aelevine99/ME691_Windshield-Heater/Photos/PXL_20240503_170951732.jpg

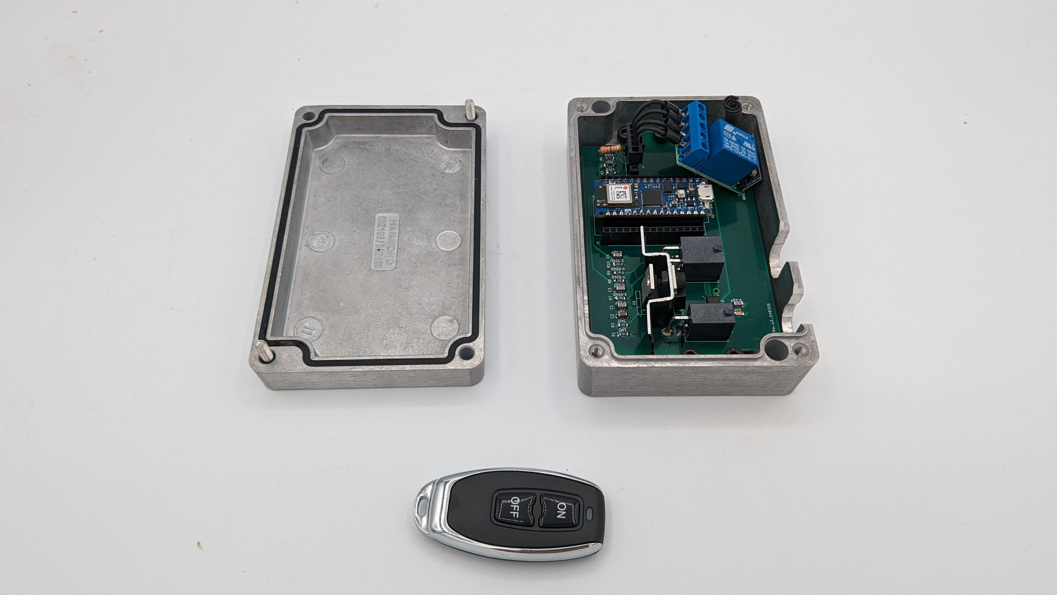
Photos/PXL_20240503_170951732.jpg
