aelevine99/ME691_Windshield-Heater/CAD/Drawing Die-Cut.pdf

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

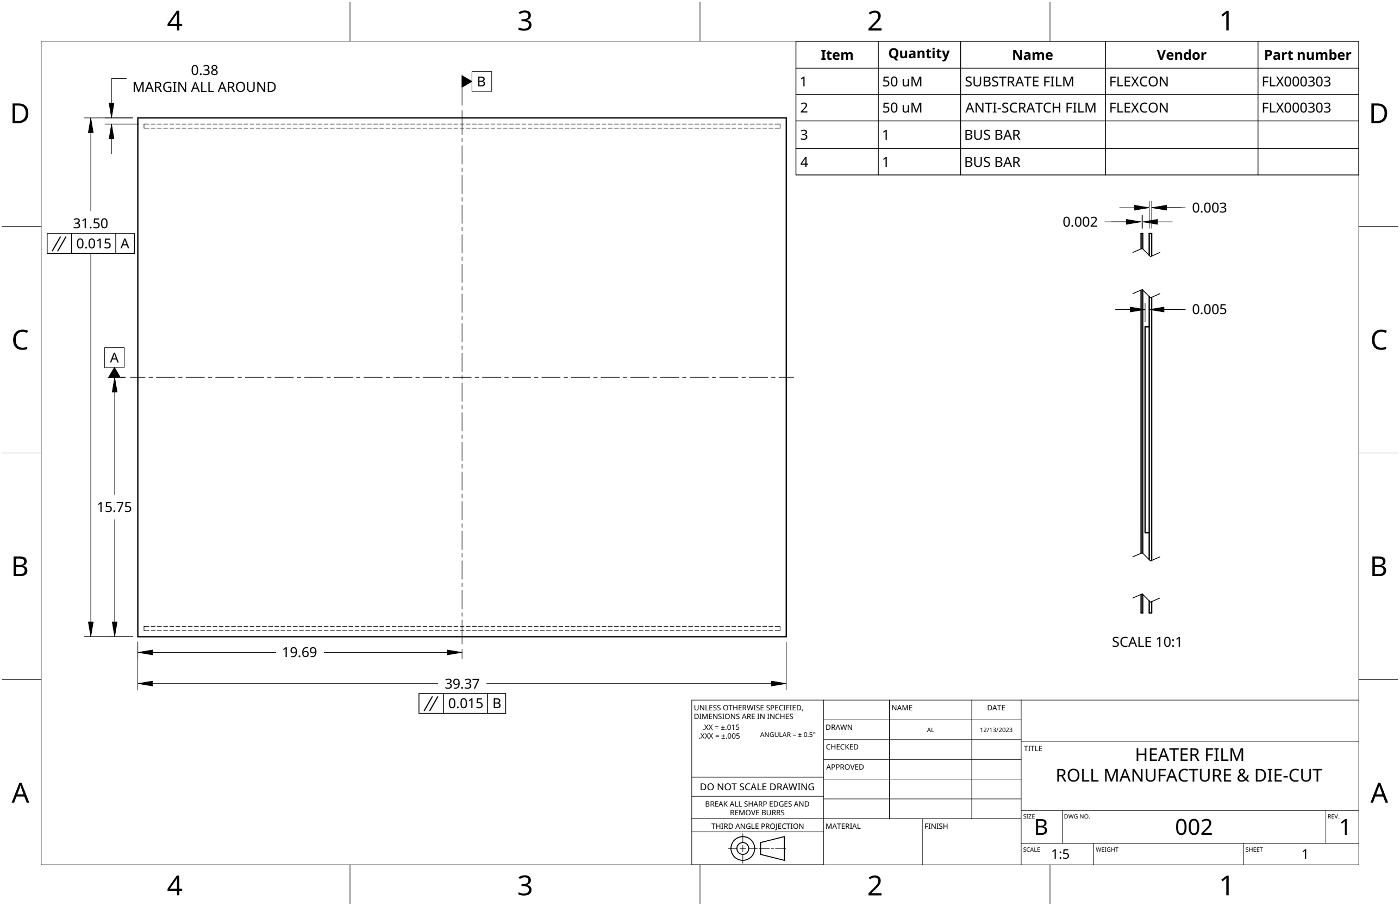
[picture p3: figure]
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
