aelevine99/ME691_Windshield-Heater/kicad/V3/render_iso.png

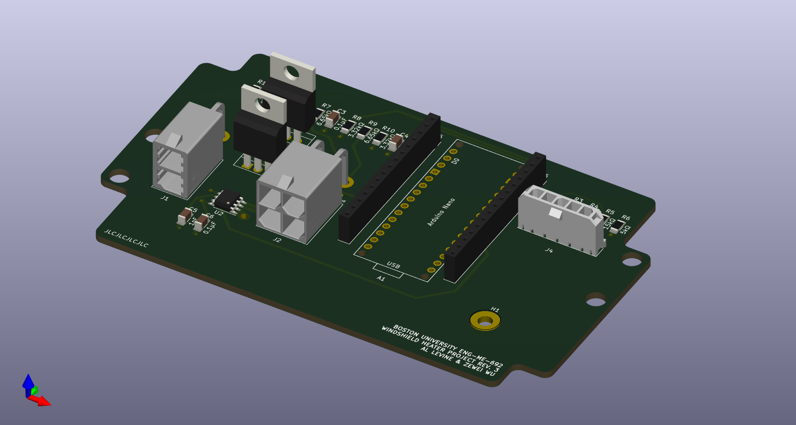
kicad/V3/render_iso.png
