aelevine99/ME691_Windshield-Heater/Photos/PXL_20240503_170716707.jpg

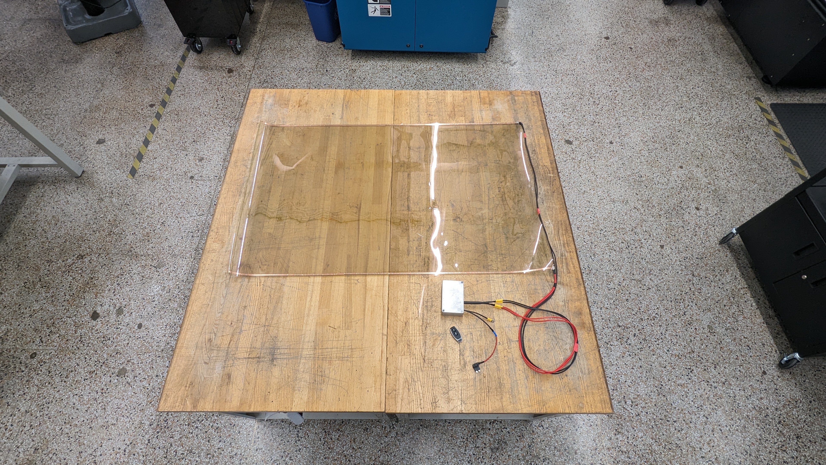
Photos/PXL_20240503_170716707.jpg
