aelevine99/ME691_Windshield-Heater/Photos/PXL_20240503_171204627.jpg

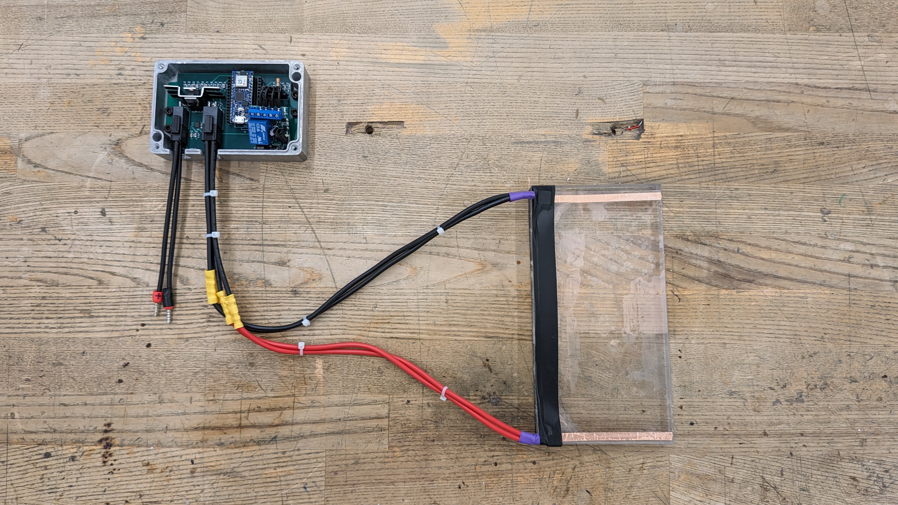
Photos/PXL_20240503_171204627.jpg
