aelevine99/ME691_Windshield-Heater/enclosure/Part Studio 1 - PCB.dxf

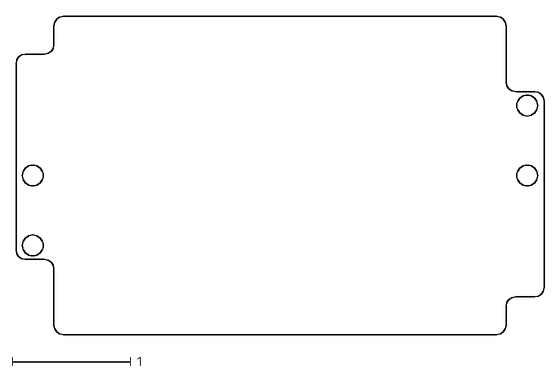
[picture p10: CAD file, 2024-02-08]
enclosure/Part Studio 1 - PCB.dxf
4.46 x 2.69
