aelevine99/ME691_Windshield-Heater/enclosure/1550Z107 asm v1 090904.stp

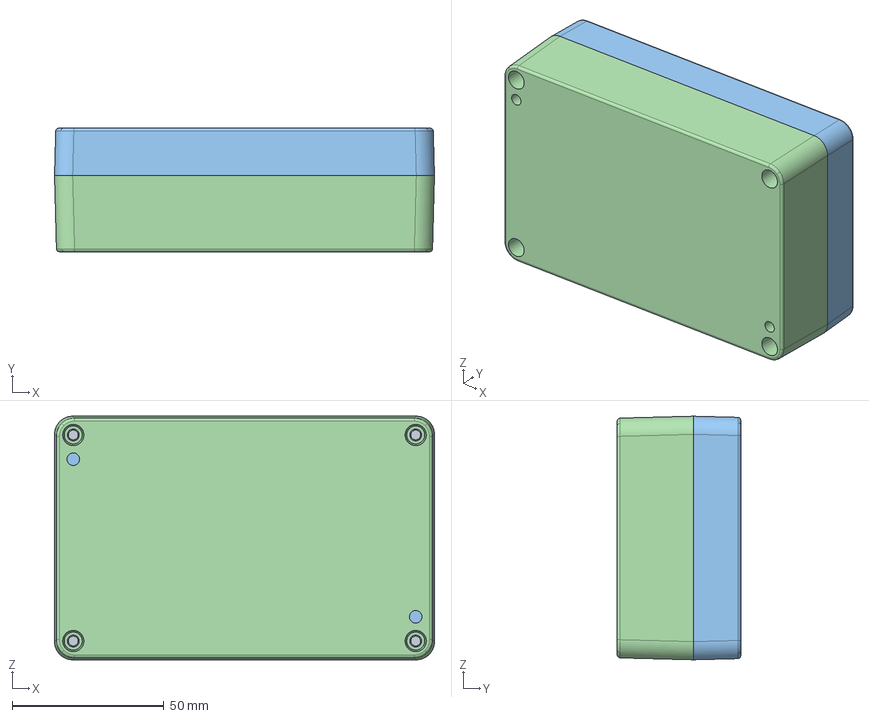
[picture p11: CAD file, 2024-02-06]
enclosure/1550Z107 asm v1 090904.stp
125.4 x 40.8 x 80.4 mm
M4x0.7x30 Flat Cross_B18.6.7M - M4 x 0.7 x 40 Type I Cross Recessed FHMS --40N x 4
1550Z107 gasket v1 091103_w]
1550Z108 LID v1 090904_w]
1550Z107 BOX v1 090904_w]
