aelevine99/ME691_Windshield-Heater/kicad/symbols/0768250004.STEP

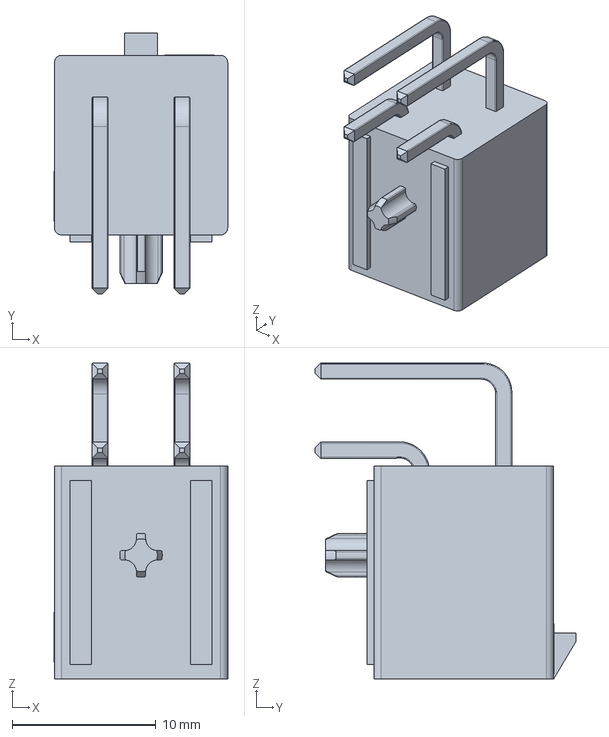
[picture p12: CAD file, 2024-03-22]
kicad/symbols/0768250004.STEP
12.1 x 18.1 x 22.0 mm
