aelevine99/ME691_Windshield-Heater/kicad/symbols/0436500400.step

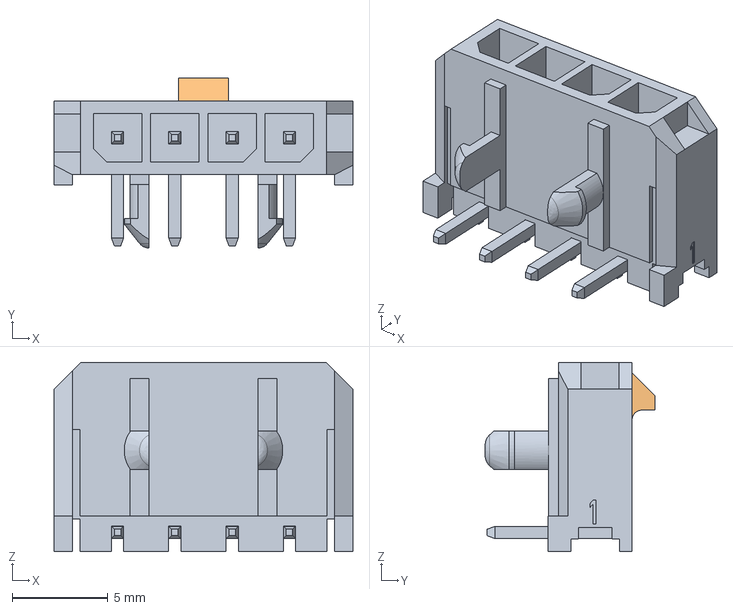
[picture p13: CAD file, 2024-02-15]
kicad/symbols/0436500400.step
15.7 x 8.91 x 9.90 mm
