aelevine99/ME691_Windshield-Heater/kicad/symbols/0768250002.step

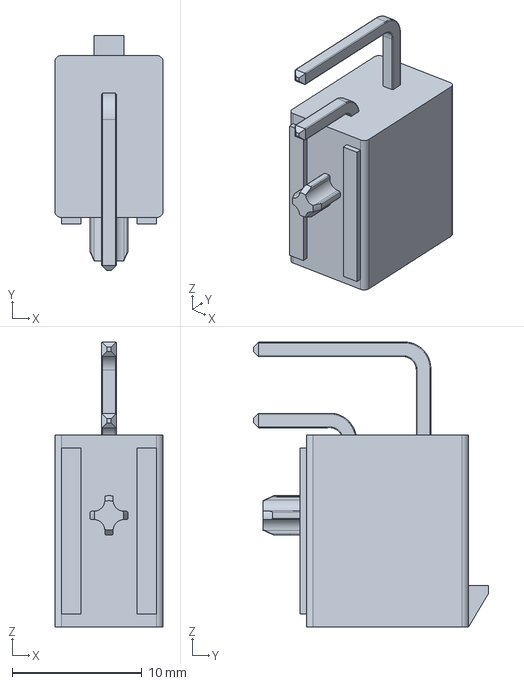
[picture p14: CAD file, 2024-02-15]
kicad/symbols/0768250002.step
8.35 x 18.1 x 22.0 mm
