aelevine99/ME691_Windshield-Heater/kicad/symbols/436500515.step

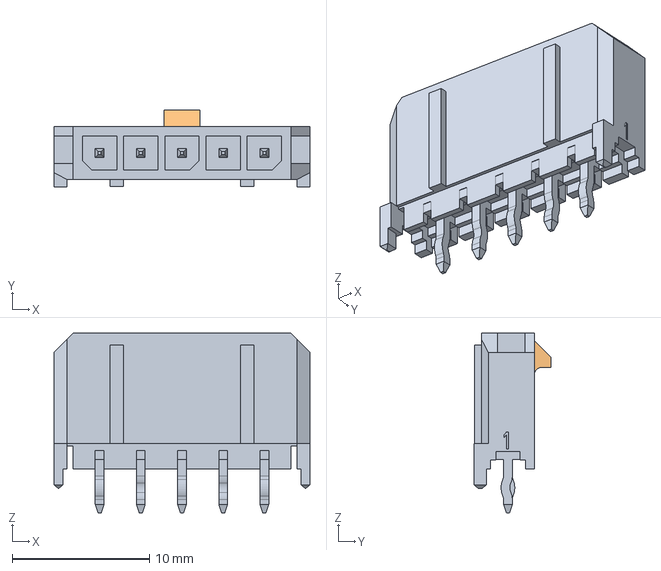
[picture p15: CAD file, 2024-02-15]
kicad/symbols/436500515.step
18.6 x 5.61 x 13.1 mm
