aelevine99/ME691_Windshield-Heater/(list of files, cad)

Other CAD files:
enclosure/1550Z107.dwg
