aelevine99/ME691_Windshield-Heater/CAD/Foil Connector.pdf

4

3

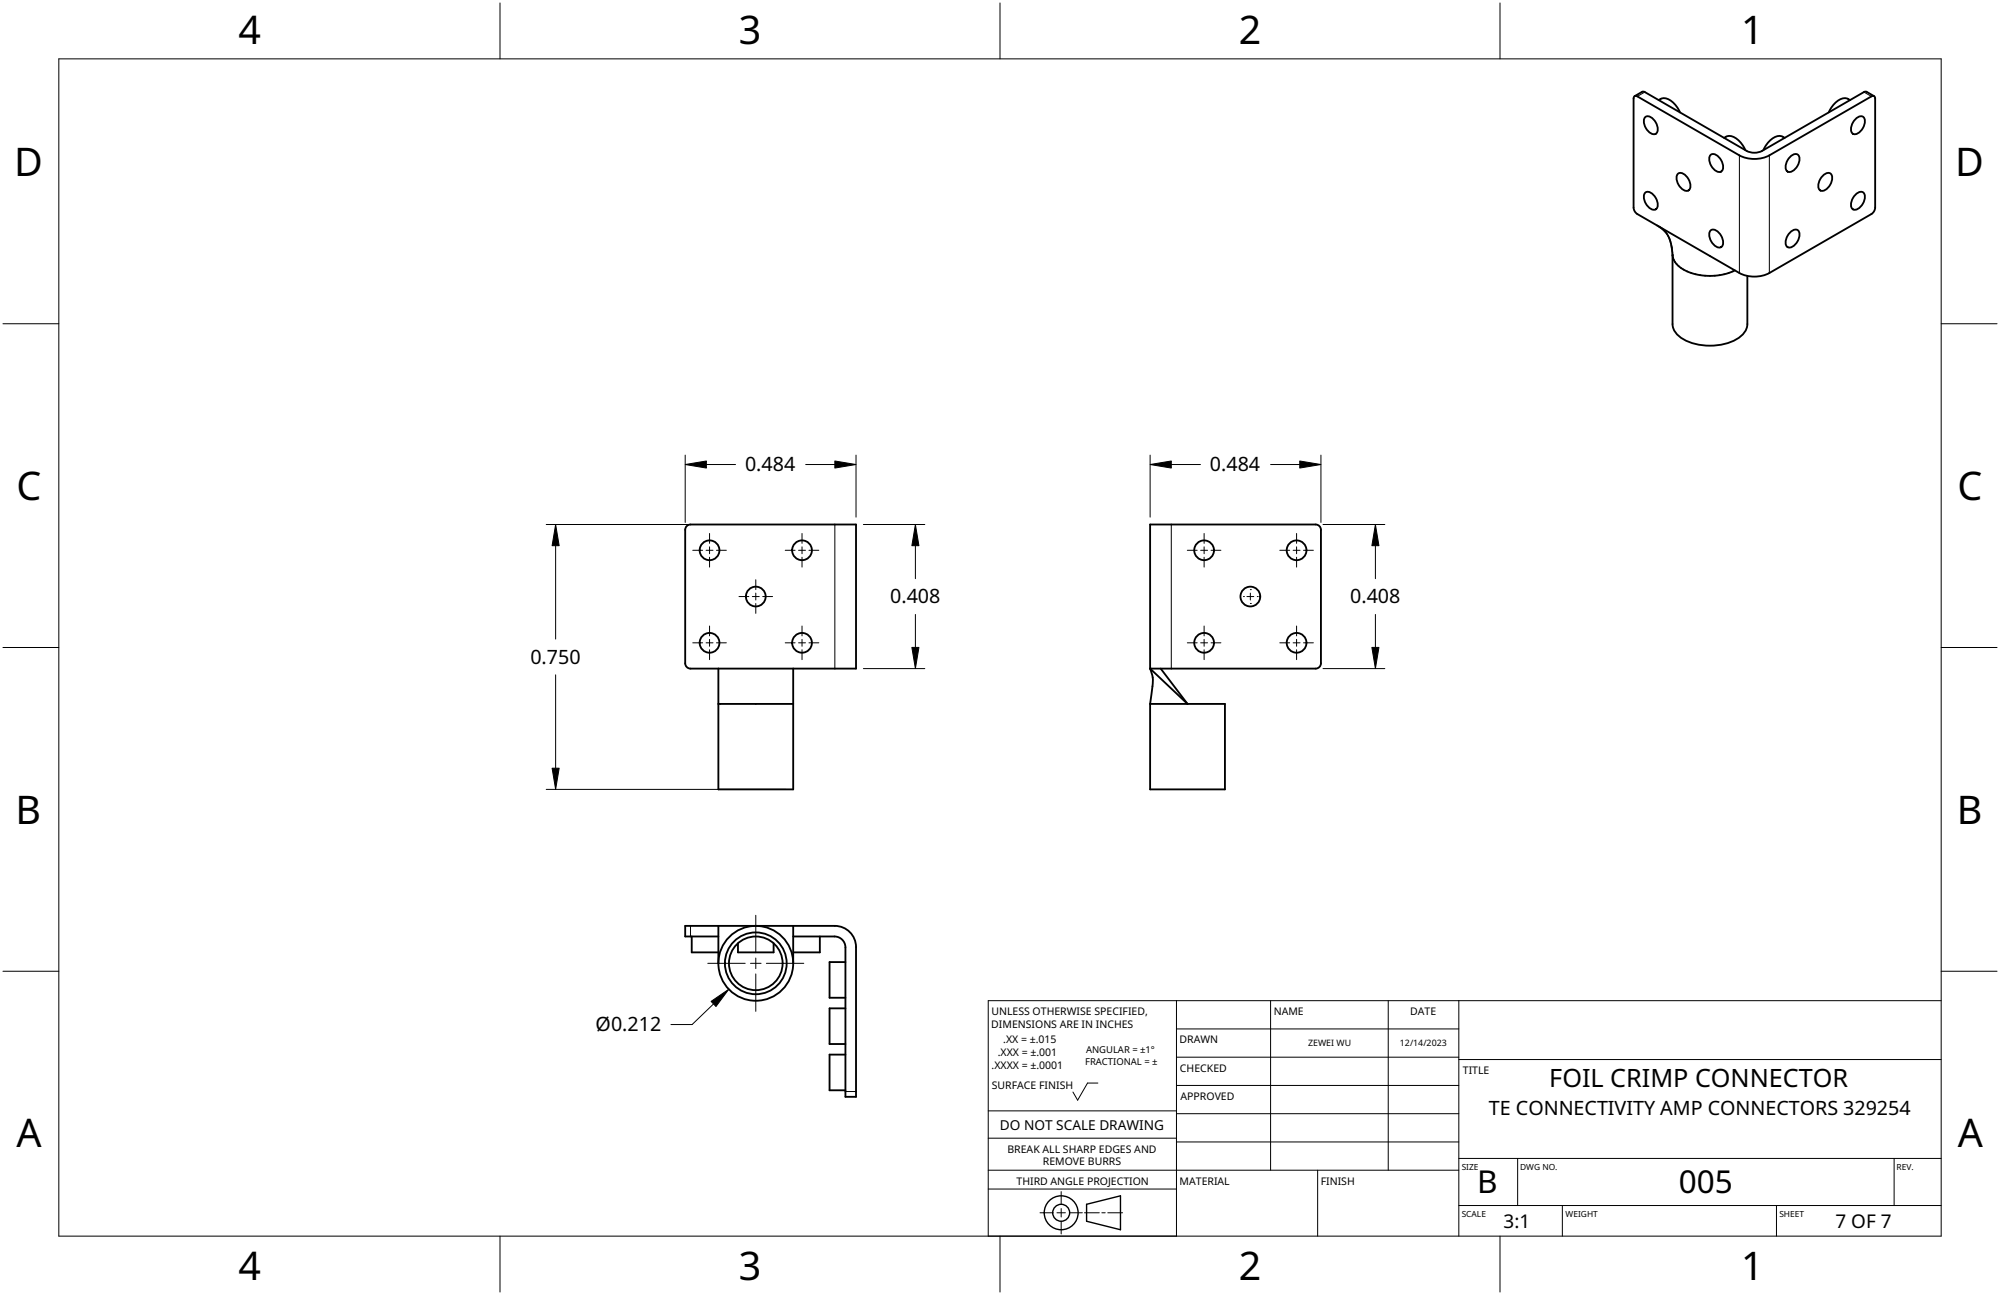
[picture p16: page 1]
MATERIAL; FINISH

UNLESS OTHERWISE SPECIFIED, DIMENSIONS ARE IN INCHES .XX = ±.015 ANGULAR = ±1° .XXX = ±.001 .XXXX = ±.0001 FRACTIONAL = ± SURFACE FINISH | | NAME | DATE

DRAWN | ZEWEI WU | 12/14/2023

CHECKED | | | TITLE FOIL CRIMP CONNECTOR TE CONNECTIVITY AMP CONNECTORS 329254

APPROVED

DO NOT SCALE DRAWING

BREAK ALL SHARP EDGES AND

REMOVE BURRS
THIRD ANGLE PROJECTION

SIZE B | DWG NO. 005 | REV.

SCALE 3:1 | WEIGHT | SHEET
