aelevine99/ME691_Windshield-Heater/CAD/moniOTO Drawing.pdf

4

3

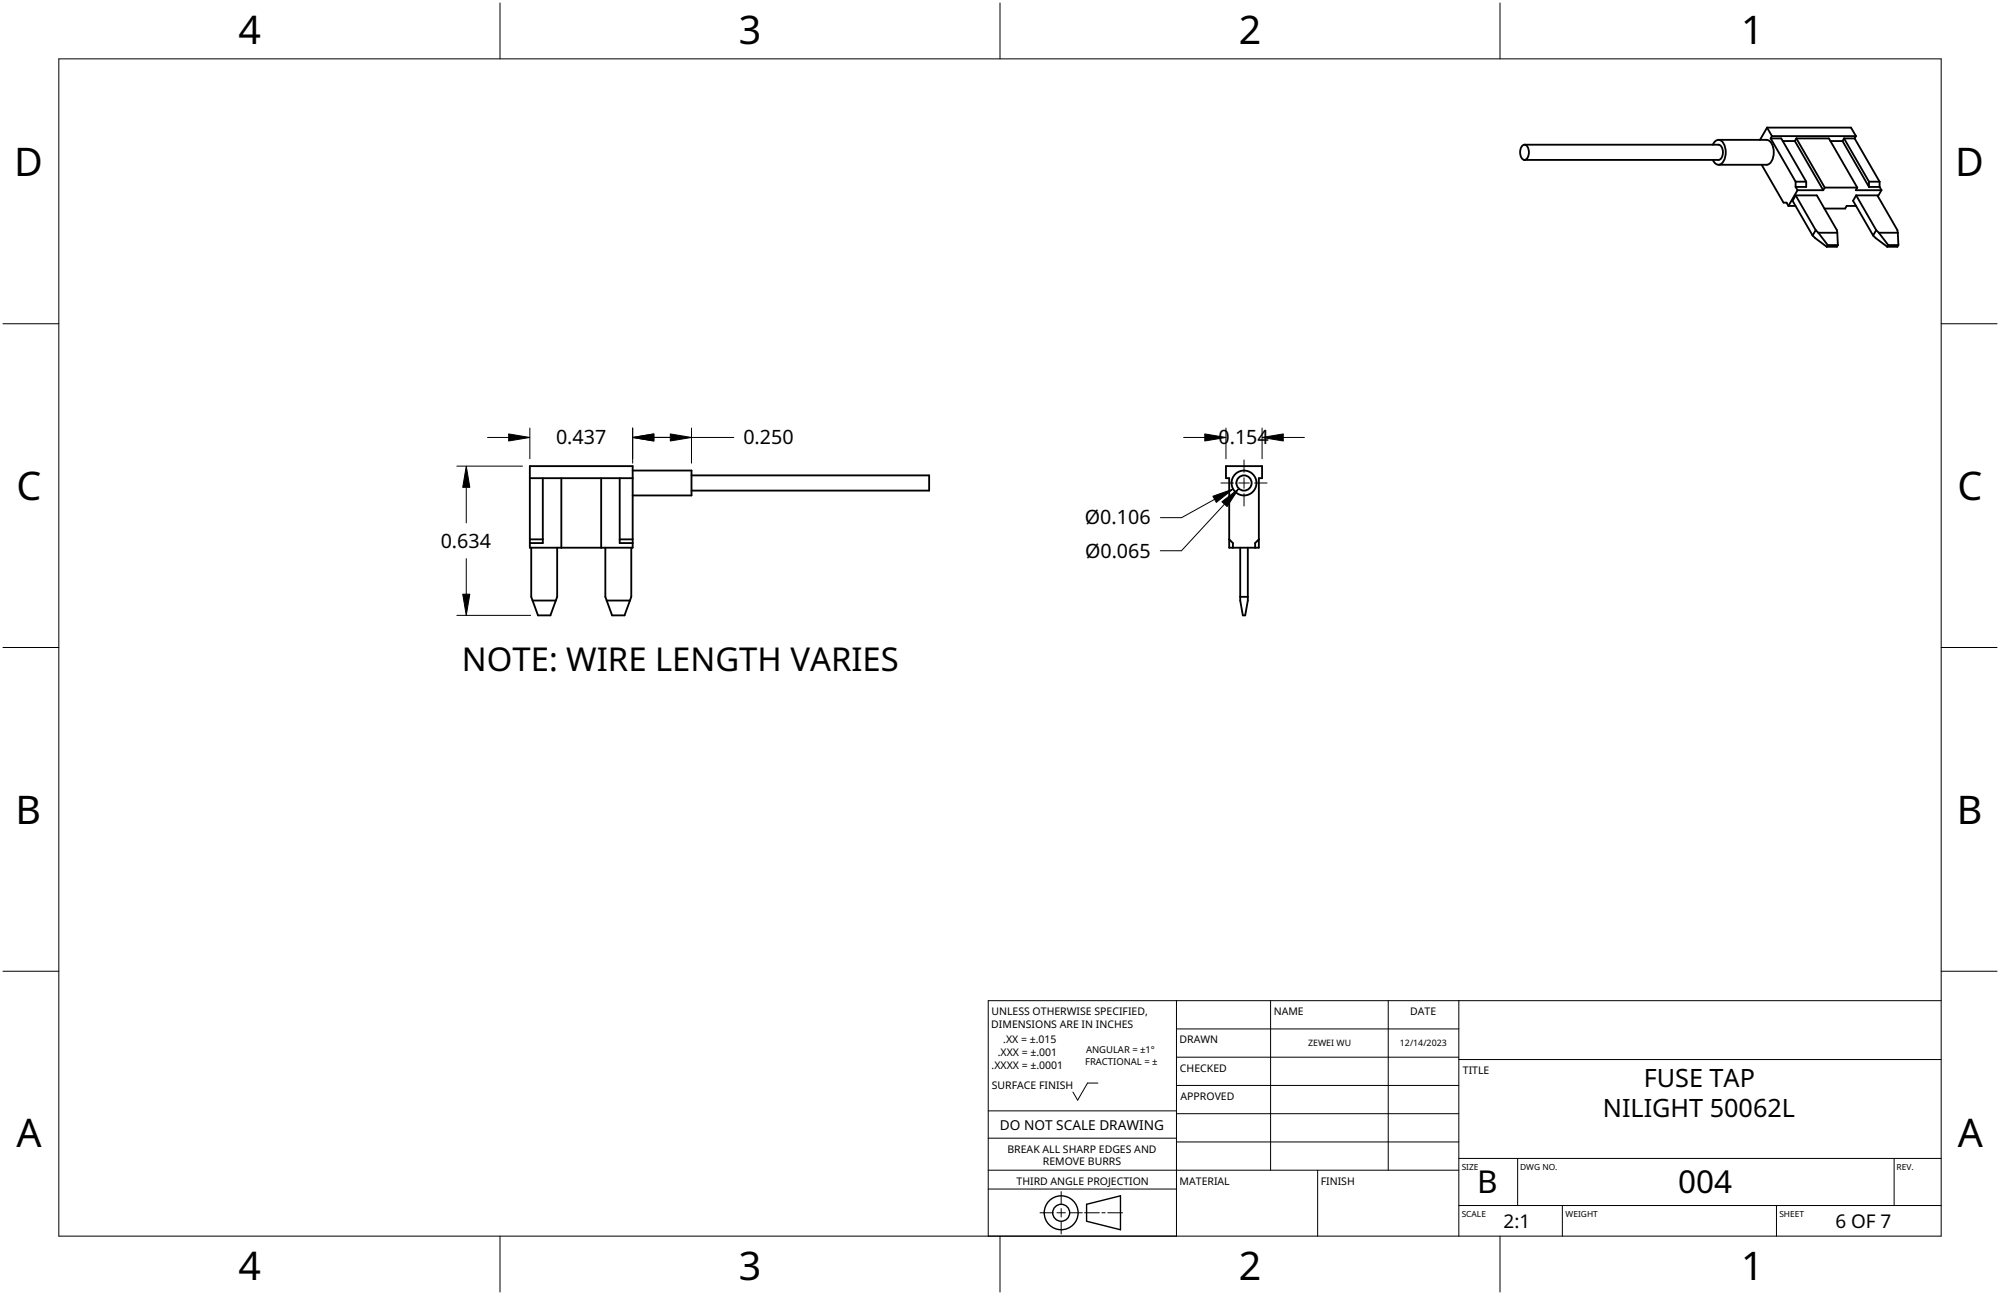
[picture p17: page 1]
MATERIAL; FINISH

NOTE: WIRE LENGTH VARIES

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

DRAWN | ZEWEI WU | 12/14/2023

CHECKED | | | TITLE FUSE TAP NILIGHT 50062L

APPROVED

DO NOT SCALE DRAWING

BREAK ALL SHARP EDGES AND

REMOVE BURRS
THIRD ANGLE PROJECTION

SIZE B | DWG NO. 004 | REV.

SCALE 2:1 | WEIGHT | SHEET
