aelevine99/ME691_Windshield-Heater/kicad/V3/heaterboard-3.pdf

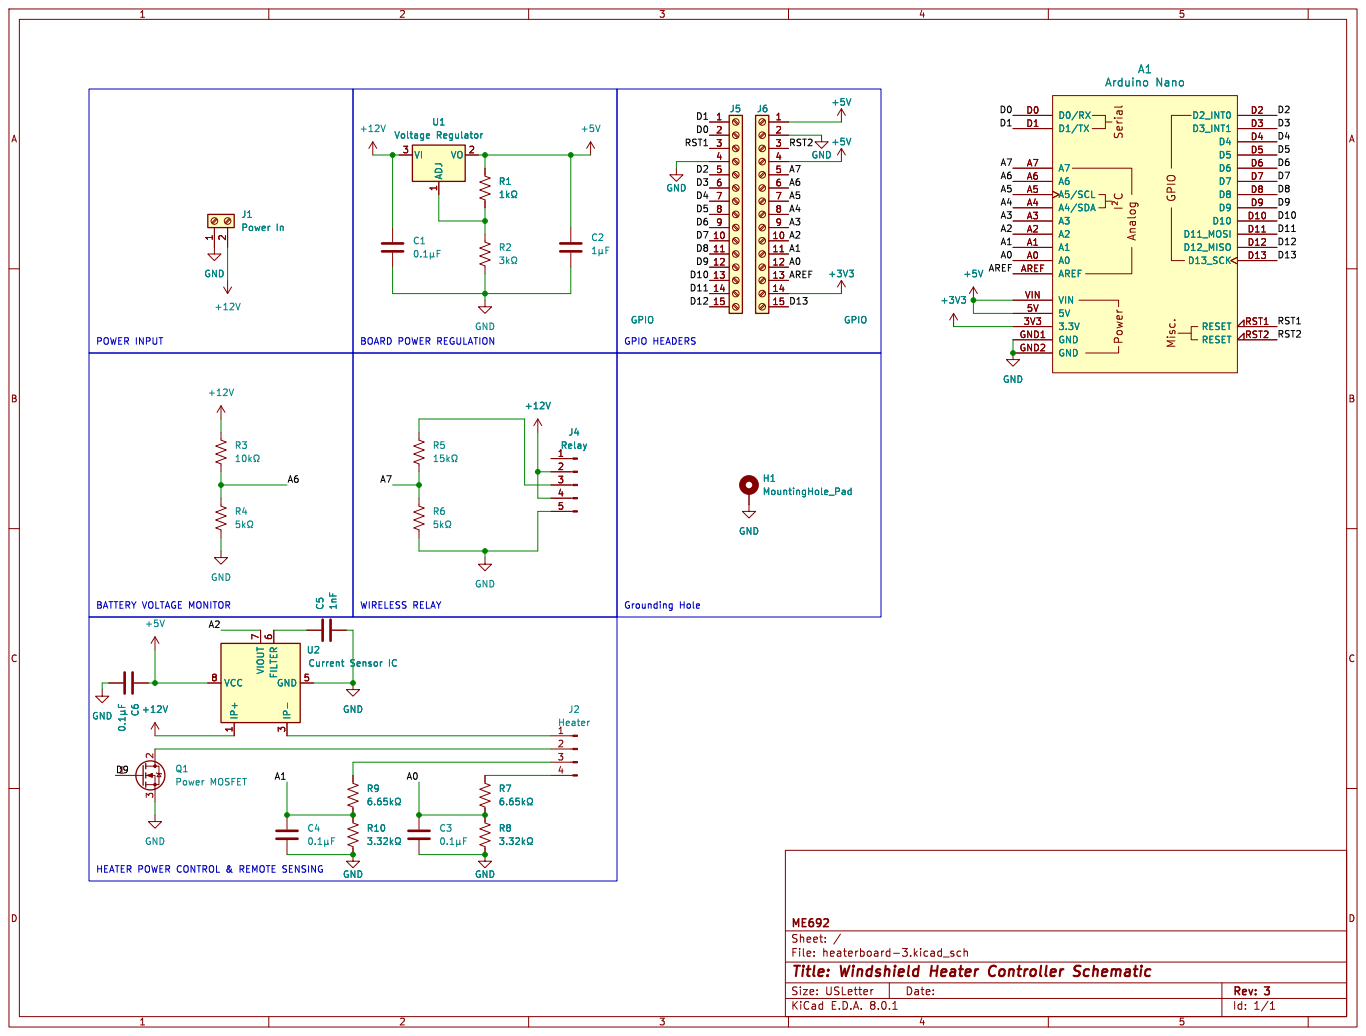
[picture p18: page 1]

7 VCC 8 U2Current Sensor IC GND C5 1nF

7 VCC 8 GND GND GND GND

HEATER POWER CONTROL & REMOTE SENSING

Id: 1/1 Title: Windshield Heater Controller Schematic
