aelevine99/ME691_Windshield-Heater/CAD/schematic.pdf

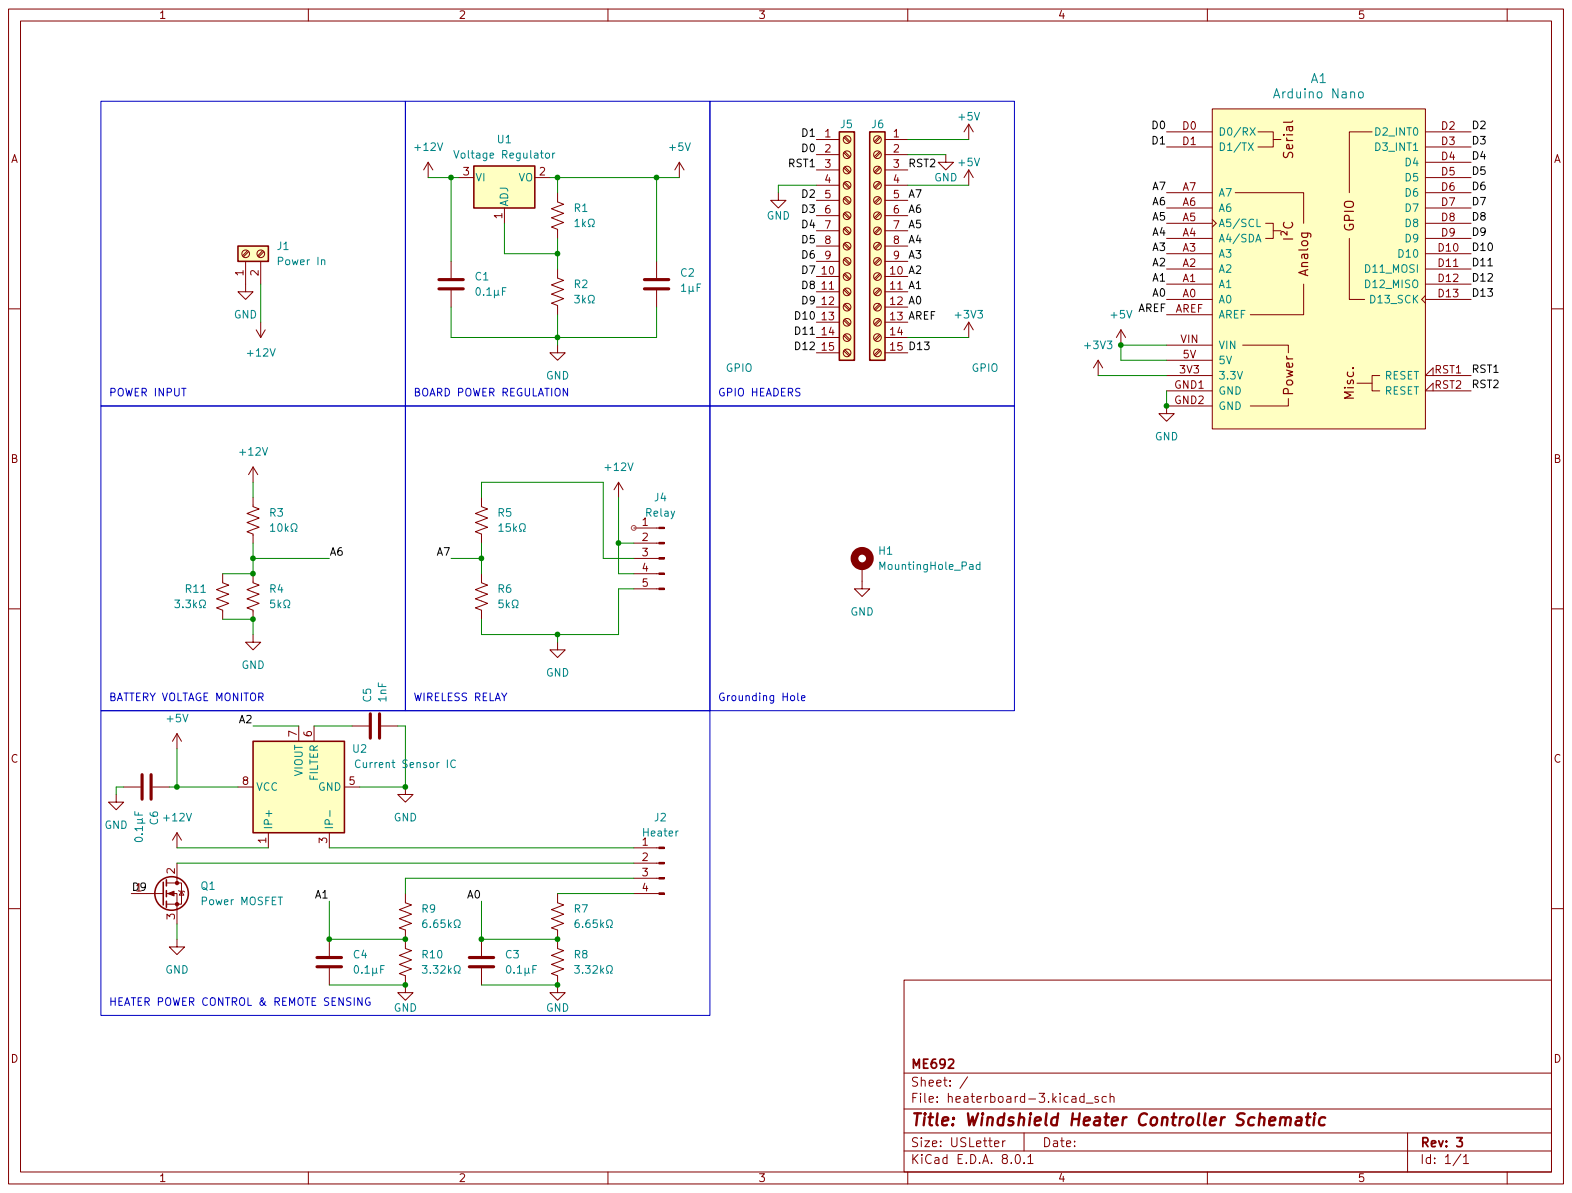
[picture p20: page 1]
