aelevine99/ME691_Windshield-Heater/CAD/Control Box Drawing.pdf

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

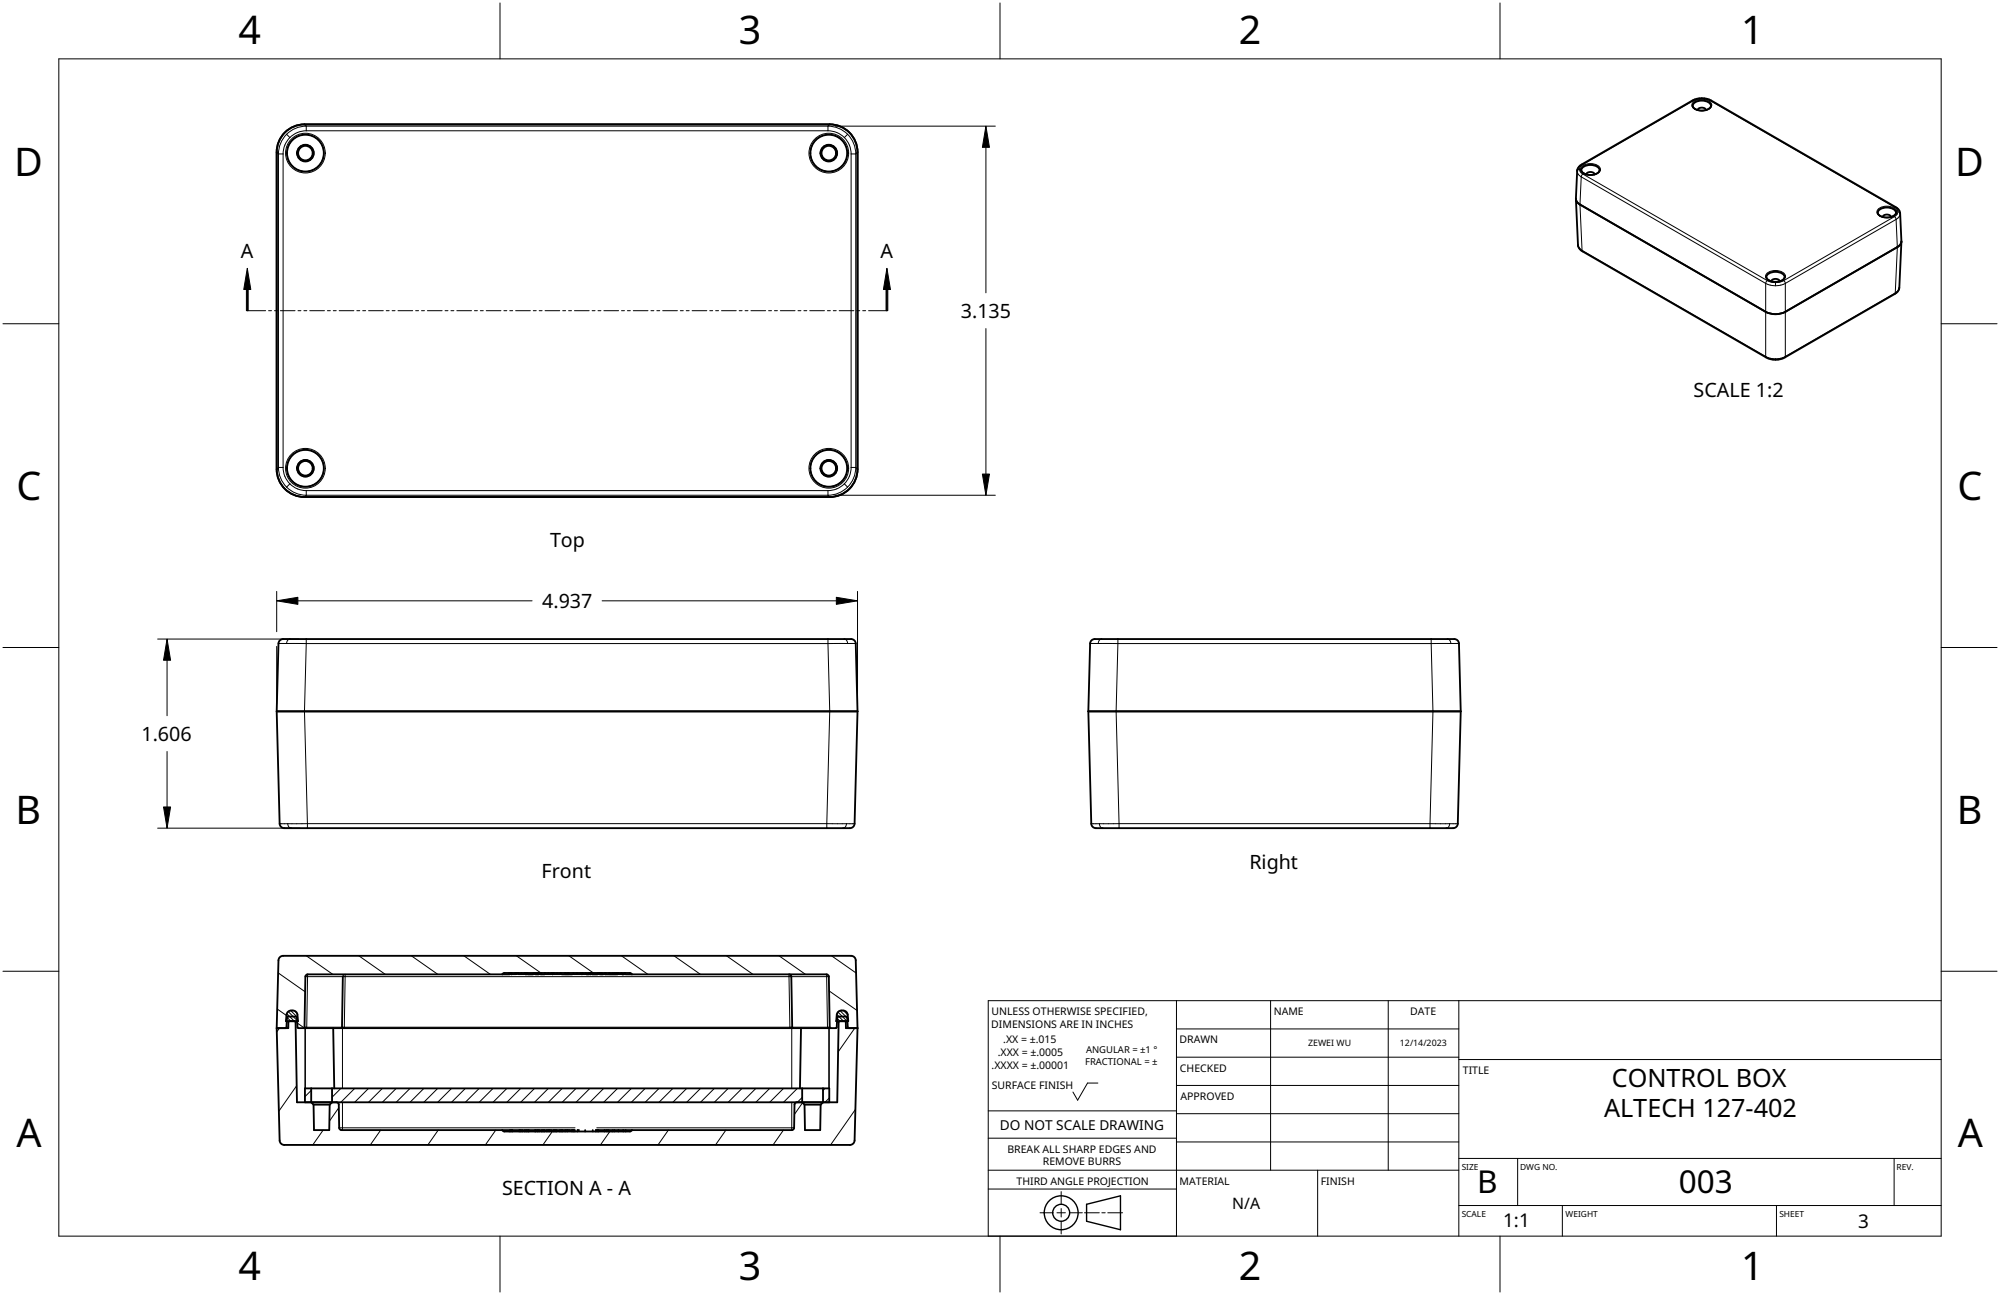
[picture p21: page 1]
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
