aelevine99/ME691_Windshield-Heater/CAD/pcb.pdf

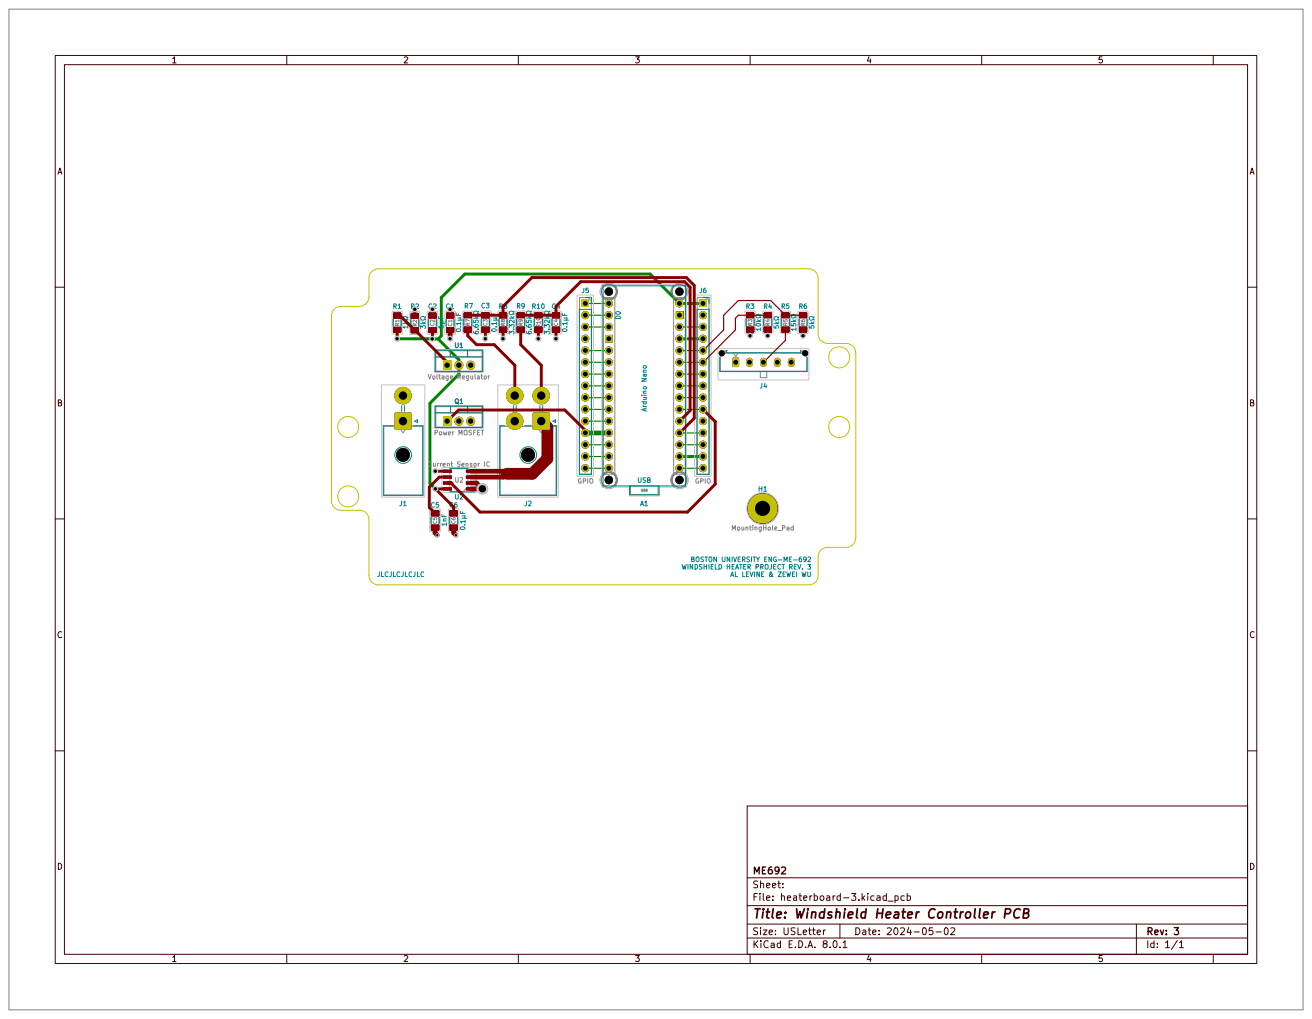
[picture p22: page 1]
