aelevine99/ME691_Windshield-Heater/kicad/V3/heaterboard-3.kicad_pcb

## KiCad design kicad/V3/heaterboard-3.kicad_pcb (2024-05-02)

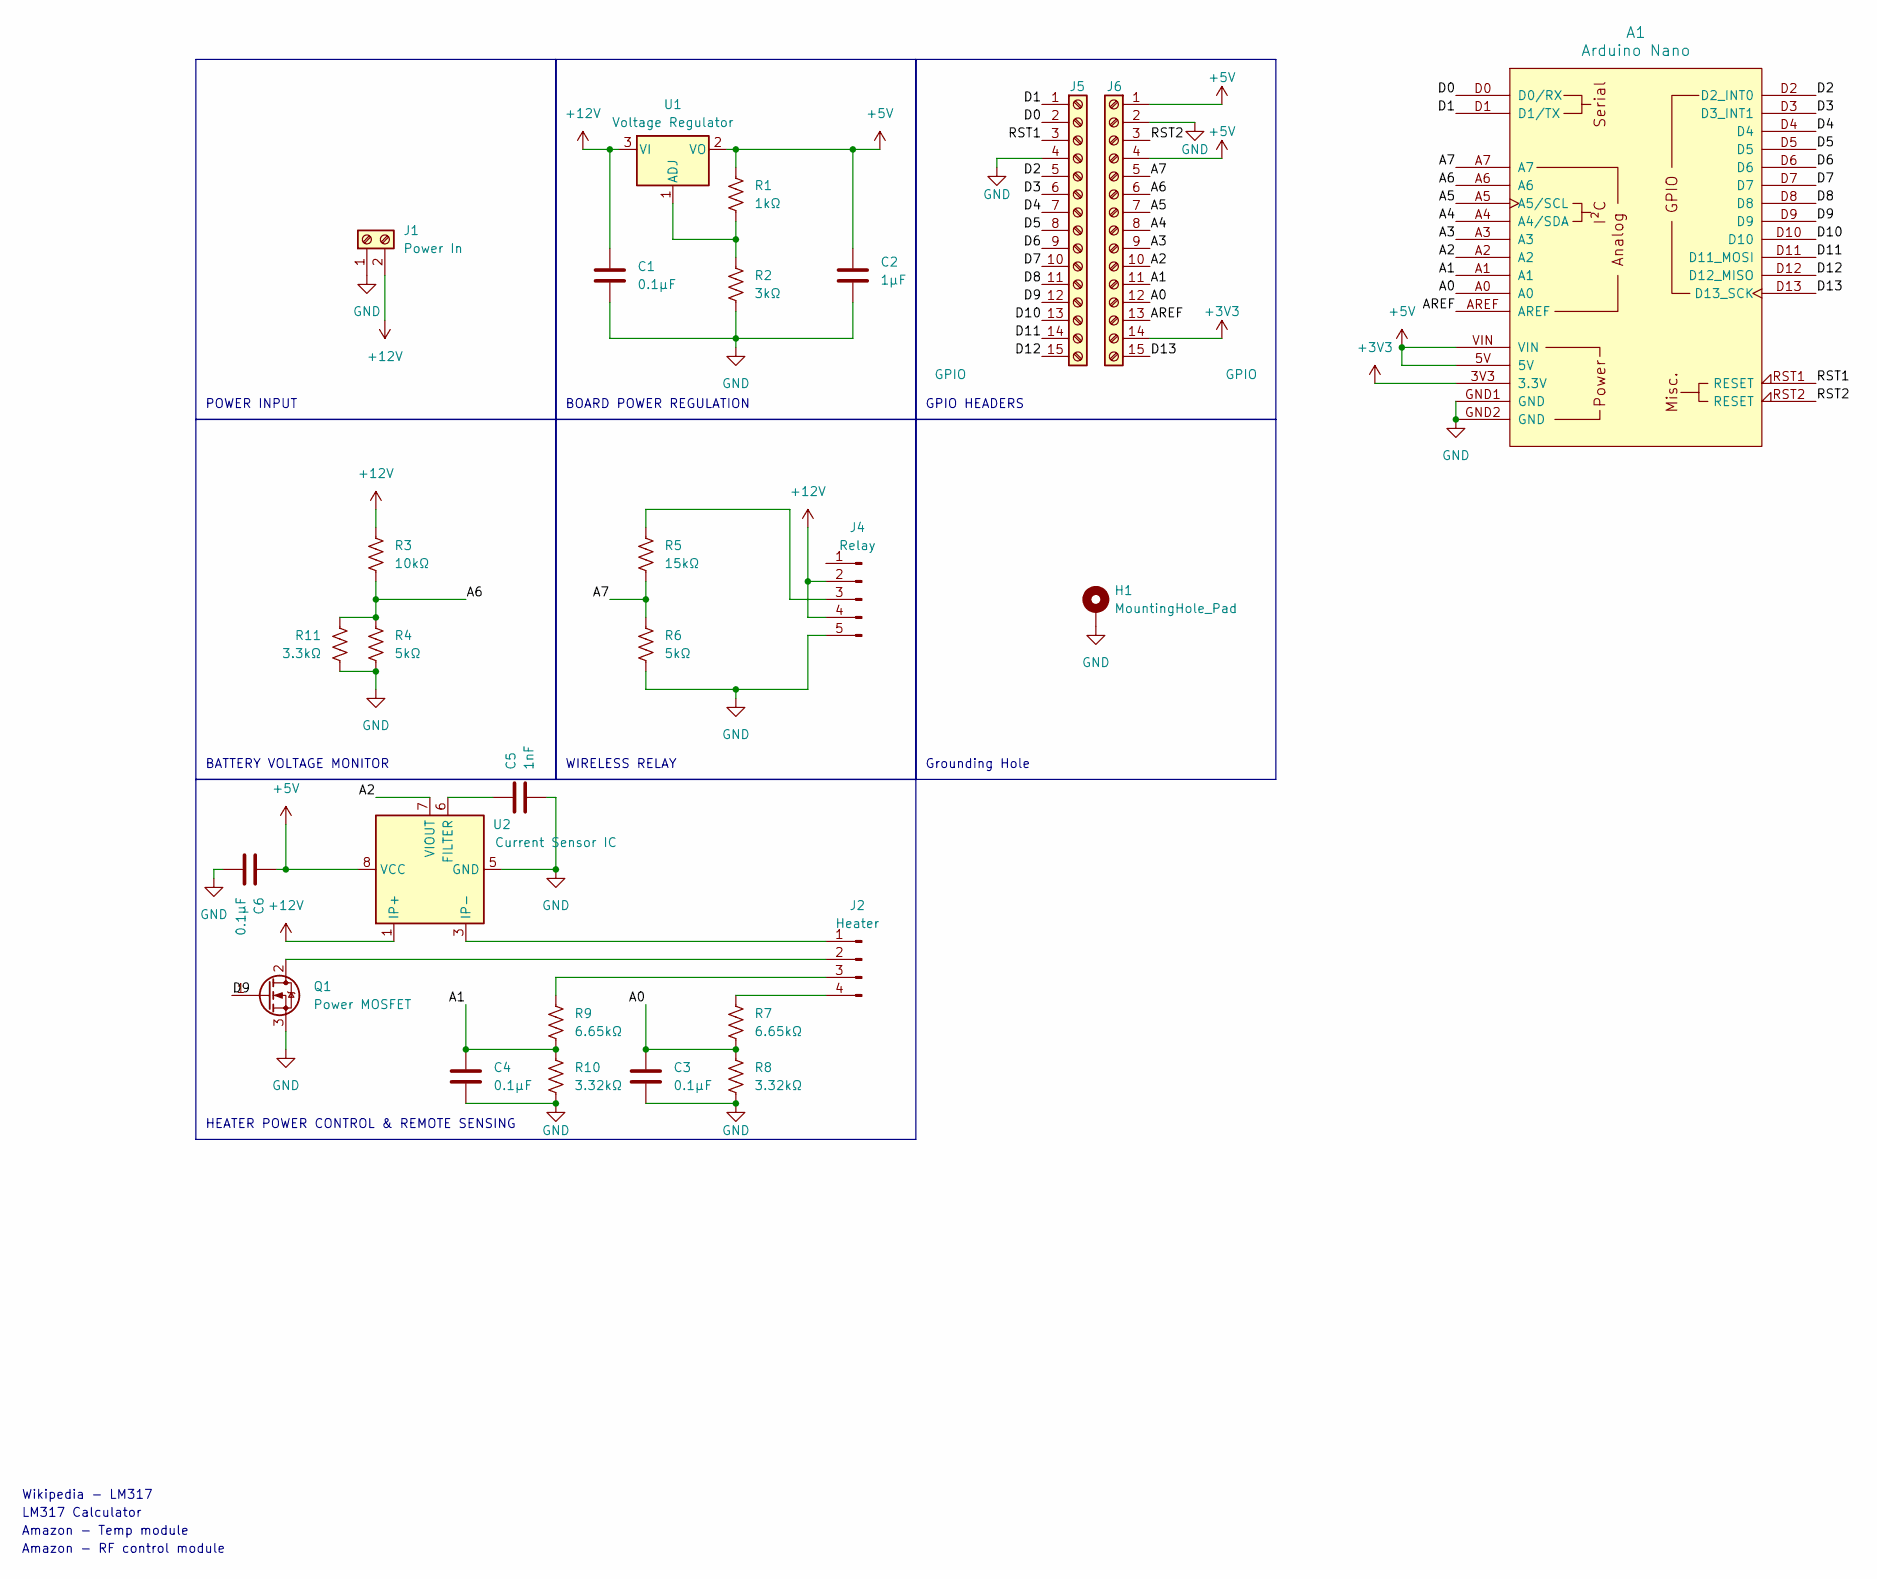
[picture p23: schematic heaterboard-3.kicad_sch, Windshield Heater Controller Schematic]

Parts:
A1: Arduino Nano; Arduino_Nano_Socket
C1, C3, C4, C6: 0.1μF; C_1206_3216Metric_Pad1.33x1.80mm_HandSolder
C2: 1μF; C_1206_3216Metric_Pad1.33x1.80mm_HandSolder
C5: 1nF; C_1206_3216Metric_Pad1.33x1.80mm_HandSolder
H1: MountingHole_Pad; MountingHole_3.2mm_M3_Pad
J1: Power In; Molex_Mega-Fit_76825-0002_2x01_P5.70mm_Horizontal
J2: Heater; Molex_Mega-Fit_76825-0004_2x02_P5.70mm_Horizontal
J4: Relay; Molex_Micro-Fit_3.0_43650-0515_1x05_P3.00mm_Vertical
J5, J6: GPIO; PinSocket_1x15_P2.54mm_Vertical
Q1: Power MOSFET; TO-220-3_Vertical
R1: 1kΩ; R_1206_3216Metric_Pad1.30x1.75mm_HandSolder
R2: 3kΩ; R_1206_3216Metric_Pad1.30x1.75mm_HandSolder
R3: 10kΩ; R_1206_3216Metric_Pad1.30x1.75mm_HandSolder
R4, R6: 5kΩ; R_1206_3216Metric_Pad1.30x1.75mm_HandSolder
R5: 15kΩ; R_1206_3216Metric_Pad1.30x1.75mm_HandSolder
R7, R9: 6.65kΩ; R_1206_3216Metric_Pad1.30x1.75mm_HandSolder
R8, R10: 3.32kΩ; R_1206_3216Metric_Pad1.30x1.75mm_HandSolder
R11: 3.3kΩ
U1: Voltage Regulator; TO-220-3_Vertical
U2: Current Sensor IC; SOIC-8_3.9x4.9mm_P1.27mm

Connections:
+3V3: A1.3V3 (3.3V), J6.14
+5V: A1.5V, A1.VIN, C2.1, C6.1, J6.1, J6.4, R1.1, U1.2 (VO), U2.8 (VCC)
+12V: C1.1, J1.2, J4.2, J4.4, R3.1, U1.3 (VI), U2.1 (IP+), U2.2 (IP+)
/A0: A1.A0, C3.1, J6.12, R7.2, R8.1
/A1: A1.A1, C4.1, J6.11, R9.2, R10.1
/A2: A1.A2, J6.10, U2.7 (VIOUT)
/A3: A1.A3, J6.9
/A4: A1.A4 (A4/SDA), J6.8
/A5: A1.A5 (A5/SCL), J6.7
/A6: A1.A6, J6.6, R3.2, R4.1, R11.1
/A7: A1.A7, J6.5, R5.2, R6.1
/AREF: A1.AREF, J6.13
/D0: A1.D0 (D0/RX), J5.2
/D1: A1.D1 (D1/TX), J5.1
/D2: A1.D2 (D2_INT0), J5.5
/D3: A1.D3 (D3_INT1), J5.6
/D4: A1.D4, J5.7
/D5: A1.D5, J5.8
/D6: A1.D6, J5.9
/D7: A1.D7, J5.10
/D8: A1.D8, J5.11
/D9: A1.D9, J5.12, Q1.1 (G)
/D10: A1.D10, J5.13
/D11: A1.D11 (D11_MOSI), J5.14
/D12: A1.D12 (D12_MISO), J5.15
/D13: A1.D13 (D13_SCK), J6.15
/RST1: A1.RST1 (RESET), J5.3
/RST2: A1.RST2 (RESET), J6.3
GND: A1.GND1 (GND), A1.GND2 (GND), C1.2, C2.2, C3.2, C4.2, C5.2, C6.2, H1.1, J1.1, J4.5, J5.4, J6.2, Q1.3 (S), R2.2, R4.2, R6.2, R8.2, R10.2, R11.2, U2.5 (GND)
unnamed: J2.1, U2.3 (IP-), U2.4 (IP-)
unnamed: J2.2, Q1.2 (D)
unnamed: J2.3, R9.1
unnamed: J2.4, R7.1
unnamed: J4.3, R5.1
unnamed: R1.2, R2.1, U1.1 (ADJ)
unnamed: C5.1, U2.6 (FILTER)

Notes on the sheet:
Wikipedia - LM317
BATTERY VOLTAGE MONITOR
BOARD POWER REGULATION
POWER INPUT
Amazon - RF control module
Grounding Hole
HEATER POWER CONTROL & REMOTE SENSING
Amazon - Temp module
WIRELESS RELAY
LM317 Calculator
GPIO HEADERS

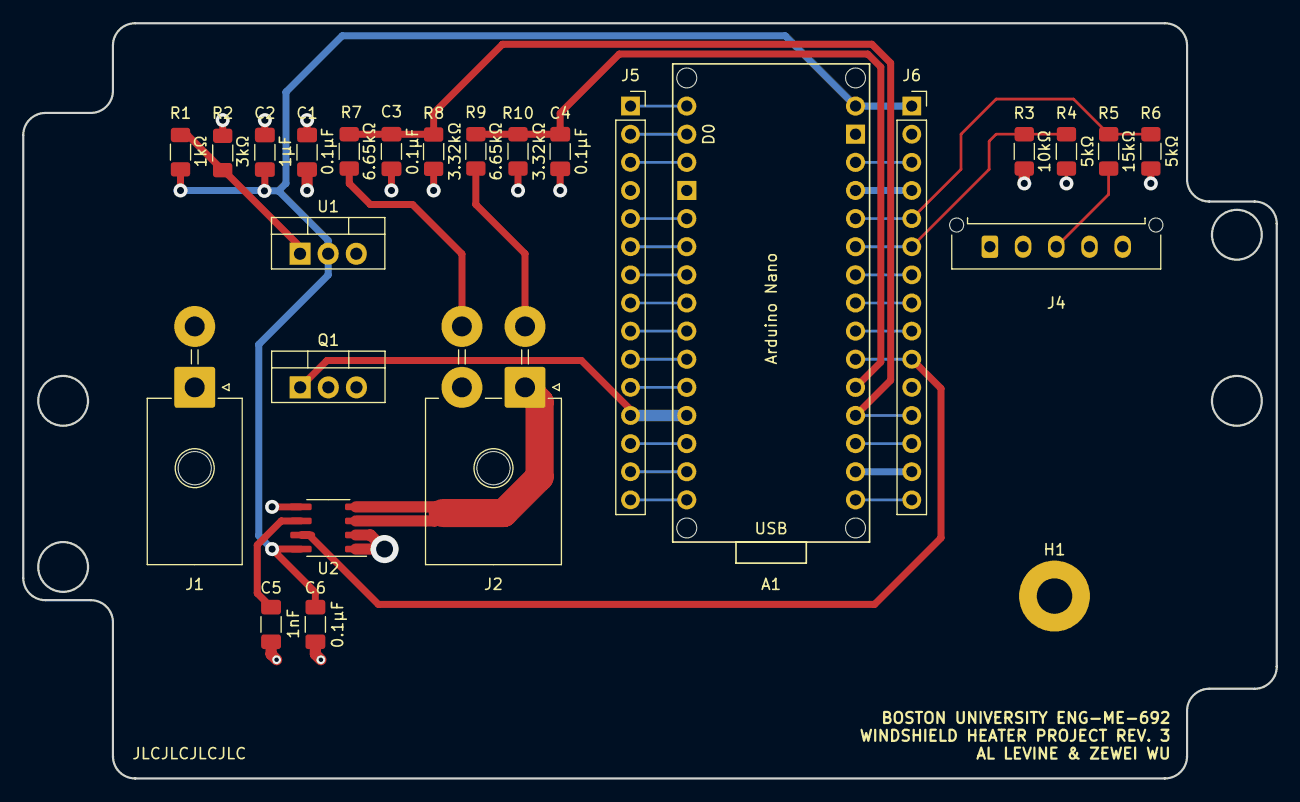
[picture p24: board heaterboard-3.kicad_pcb from above]

Board: 4 copper layers, 113.2 x 68.2 mm, 26 parts (0 on the bottom side), 36 nets.
