aelevine99/ME691_Windshield-Heater/kicad/V1/heaterboard.kicad_pcb

## KiCad design kicad/V1/heaterboard.kicad_pcb (2024-02-01, an earlier design)

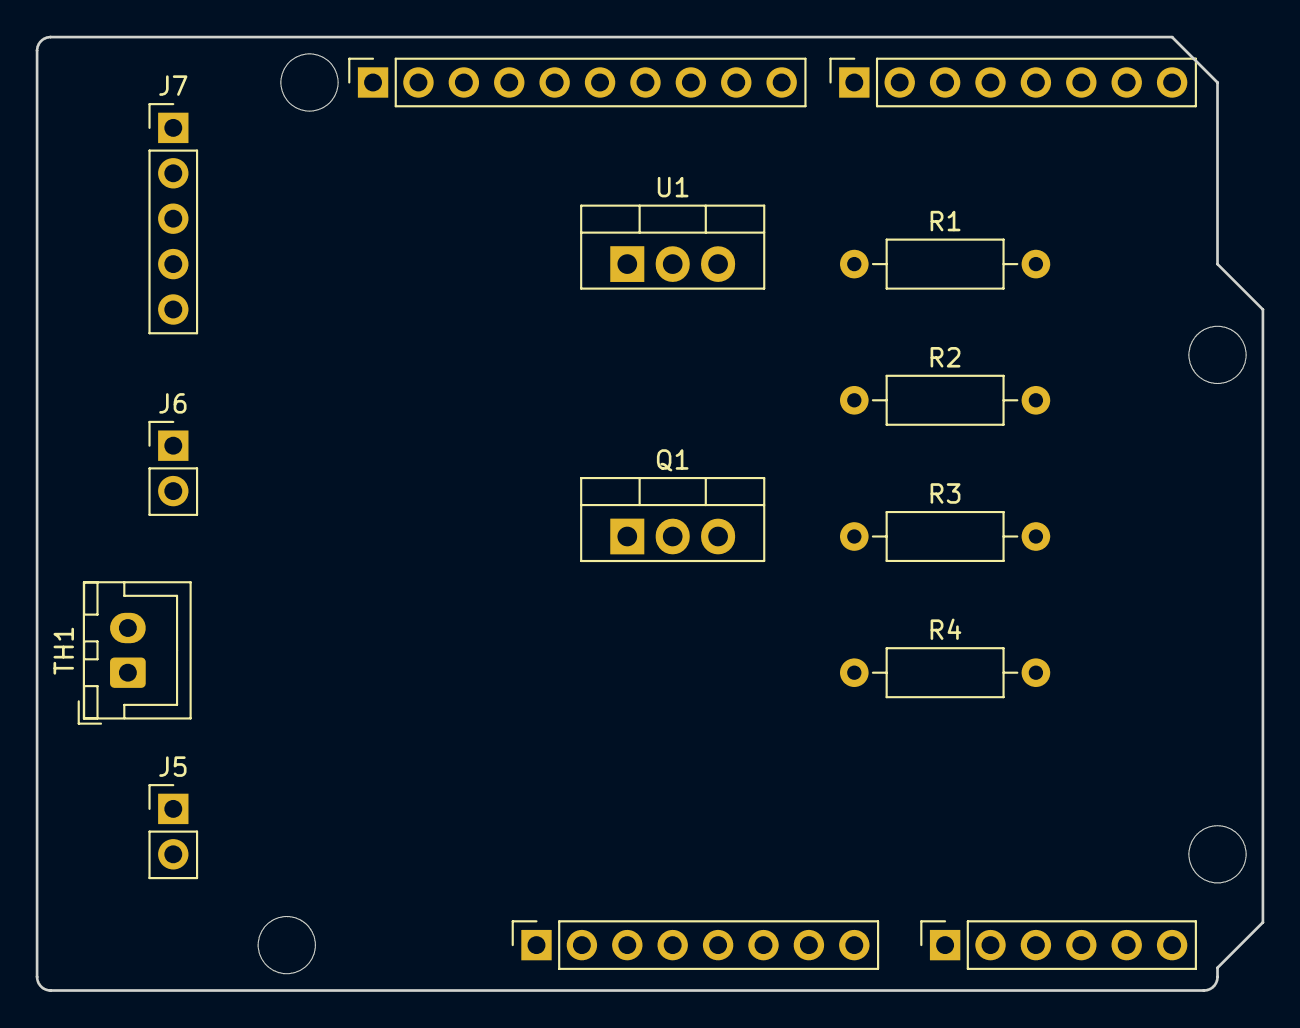
[picture p25: board heaterboard.kicad_pcb from above]

Board: 4 copper layers, 68.6 x 53.3 mm, 18 parts (0 on the bottom side), 11 nets, no tracks yet.

Parts:
J1: Power; PinSocket_1x08_P2.54mm_Vertical
J2: Digital/PWM; PinSocket_1x10_P2.54mm_Vertical
J3: Analog; PinSocket_1x06_P2.54mm_Vertical
J4: Digital/PWM; PinSocket_1x08_P2.54mm_Vertical
J5, J6: Screw_Terminal_01x02; PinHeader_1x02_P2.54mm_Vertical
J7: Conn_01x05_Pin; PinHeader_1x05_P2.54mm_Vertical
MH1, MH2, MH3, MH4: MountingHole_3.2mm
Q1: Q_NMOS_GDS; TO-220-3_Vertical
R1: 10 kΩ; R_Axial_DIN0207_L6.3mm_D2.5mm_P10.16mm_Horizontal
R2, R4: 5 kΩ; R_Axial_DIN0207_L6.3mm_D2.5mm_P10.16mm_Horizontal
R3: 15 kΩ; R_Axial_DIN0207_L6.3mm_D2.5mm_P10.16mm_Horizontal
TH1: PT100; JST_XH_B2B-XH-A_1x02_P2.50mm_Vertical
U1: LM7805_TO220; TO-220-3_Vertical

Connections:
/*3: J4.5, Q1.1 (G)
/A1: J3.2, R3.2 (-), R4.1 (+)
/A2: J3.3, TH1.2
/A3: J3.4, R1.2 (-), R2.1 (+)
/SCL/A5: J2.1, J3.6
/SDA/A4: J2.2, J3.5
unnamed: J1.6, J1.7, U1.2 (GND)
unnamed: J6.1, Q1.2 (D)
unnamed: J7.2, J7.4
unnamed: J7.3, R3.1 (+)
unnamed: J7.5, R4.2 (-)
