aelevine99/ME691_Windshield-Heater/(commit log)

2024-01-23 project creation
    [heater_board.kicad_pcb, heater_board.kicad_sch, kicad.kicad_pcb, kicad.kicad_sch]
2024-01-23 end of class 23 jan
    [heater_board.kicad_pcb, heater_board.kicad_sch, heaterboard.kicad_pcb, heaterboard.kicad_sch, kicad.kicad_sch]
2024-01-25 end of class 25 jan
    [heaterboard.kicad_pcb, heaterboard.kicad_sch]
2024-01-30 design pass 1
    [heaterboard.kicad_pcb, heaterboard.kicad_sch]
2024-01-30 end of class 30 jan
    [heaterboard.kicad_pcb, heaterboard.kicad_sch]
2024-02-01 pivot to nano
    [heaterboard-2.kicad_pcb, heaterboard-2.kicad_sch, heaterboard.kicad_pcb, heaterboard.kicad_sch]
2024-02-01 End of class 1 feb
    [heaterboard-2.kicad_pcb, heaterboard-2.kicad_sch]
2024-02-06 pcb stuff
    [heaterboard-2.kicad_pcb, heaterboard-2.kicad_sch]
2024-02-06 end of class 6 feb
    [heaterboard-2.kicad_pcb]
2024-02-06 end class02-06-2024
    [heaterboard-2.kicad_sch]
2024-02-06 pcb updates
    [1550Z107 asm v1 090904.stp, 1550Z107.dwg, heaterboard-2.kicad_pcb]
2024-02-08 pcb outline
    [1550Z107.dwg, Part Studio 1 - PCB.dxf]
2024-02-08 pcb layout
    [heaterboard-2.kicad_pcb, heaterboard-2.kicad_sch]
2024-02-13 pcb layout and began routing
    [heaterboard-2.kicad_pcb, heaterboard-2.kicad_sch]
2024-02-15 updated layout
    [heaterboard-2.kicad_pcb]
2024-02-15 end of class 15 feb
    [heaterboard-2.kicad_pcb, heaterboard-2.kicad_sch]
2024-02-15 anothe end of class update
    [heaterboard-2.kicad_pcb]
2024-02-15 more update
    [heaterboard-2.kicad_pcb, heaterboard-2.kicad_sch]
2024-02-15 Catalog No Update
    Catalog No Update
    [heaterboard-2.kicad_sch]
2024-02-15 Routing, parts, bom
    [0436500400.step, 0768250002.step, 436500515.step, BOM.xlsx, heaterboard-2.kicad_pcb, heaterboard-2.kicad_sch]
2024-02-16 gerbers fix
    [heaterboard-2-B_Cu.gbr, heaterboard-2-B_Mask.gbr, heaterboard-2-B_Paste.gbr, heaterboard-2-B_Silkscreen.gbr, heaterboard-2-Edge_Cuts.gbr, heaterboard-2-F_Cu.gbr, heaterboard-2-F_Mask.gbr, heaterboard-2-F_Paste.gbr]
2024-02-18 updated bom
    [BOM.xlsx, heaterboard-2.kicad_sch]
2024-03-07 created rev3
    [heaterboard-3-B_Cu.gbr, heaterboard-3-B_Mask.gbr, heaterboard-3-B_Paste.gbr, heaterboard-3-B_Silkscreen.gbr, heaterboard-3-Edge_Cuts.gbr, heaterboard-3-F_Cu.gbr, heaterboard-3-F_Mask.gbr, heaterboard-3-F_Paste.gbr]
2024-03-22 board r3 update
    [0768250004.STEP, heaterboard-3.kicad_pcb, heaterboard-3.kicad_sch]
2024-03-26 board r3 updates
    [heaterboard-3-B_Cu.gbr, heaterboard-3-B_Mask.gbr, heaterboard-3-B_Paste.gbr, heaterboard-3-B_Silkscreen.gbr, heaterboard-3-Edge_Cuts.gbr, heaterboard-3-F_Cu.gbr, heaterboard-3-F_Mask.gbr, heaterboard-3-F_Paste.gbr]
2024-03-28 gerbers for pcb
2024-04-09 schematics printed
2024-04-30 voltage divider, code updates
    [heaterboard-3.kicad_sch]
2024-05-02 cad files
